OMSI-Dev/Helmet_Drop/Documentation/Helmet - Block Diagram.jpg

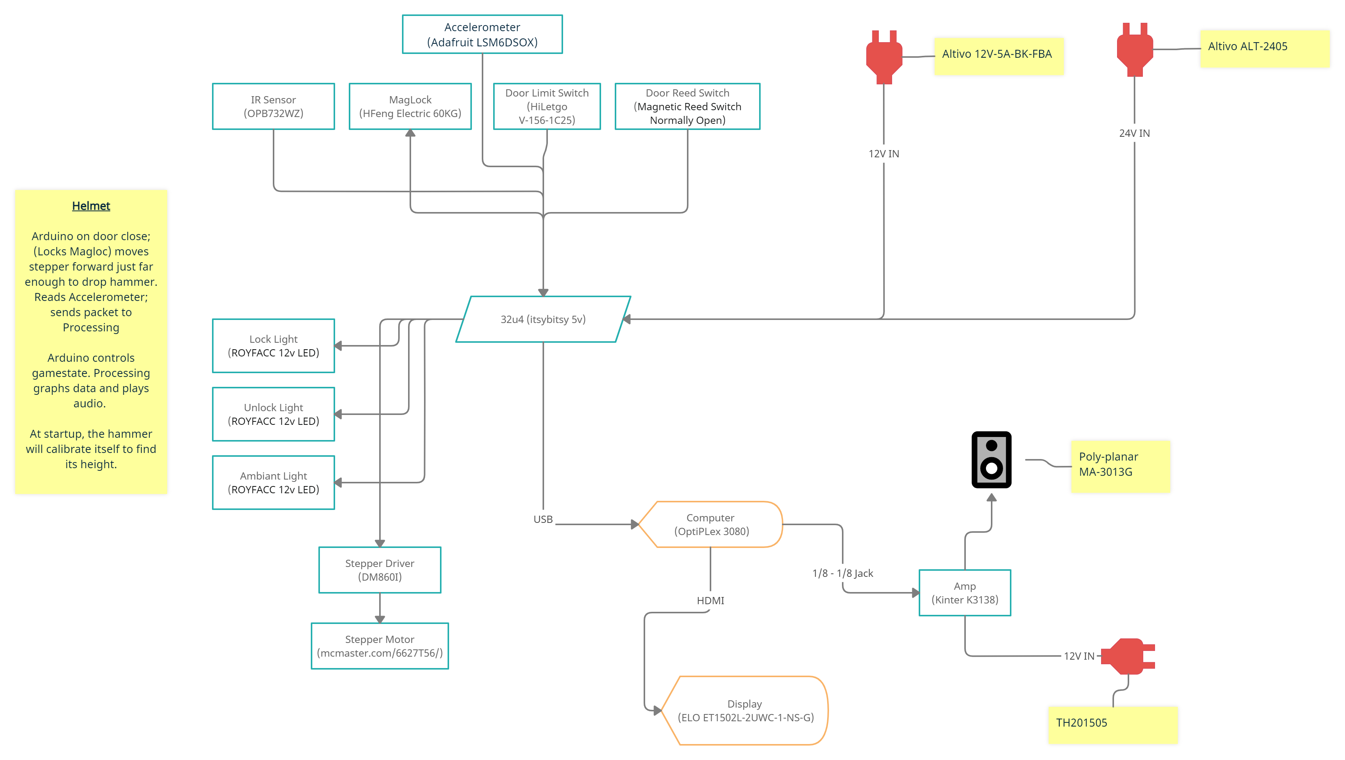
Documentation/Helmet - Block Diagram.jpg
