OMSI-Dev/Helmet_Drop/Helmet_Processing/Helmet_drop/data/images/1_en.png

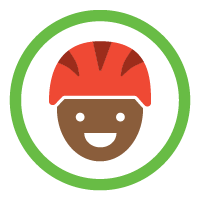
Helmet_Processing/Helmet_drop/data/images/1_en.png
