OMSI-Dev/Helmet_Drop/Helmet_Processing/Helmet_drop/data/images/2_en.png

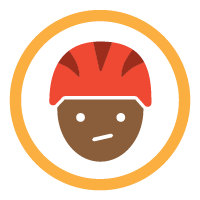
Helmet_Processing/Helmet_drop/data/images/2_en.png
