OMSI-Dev/Helmet_Drop/Documentation/Helmet - BOM.pdf

Item | QTY | Cost per Unit | Link
ItsyBitsy 5V (32u4) | 1 | $9.95 https://www.adafruit.com/product/3677
Power Strip (Relay) | 1 | $34.95 https://www.adafruit.com/product/2935
ALITOVE DC 12V 5A | 1 | $12.99 https://a.co/d/gC0HhTv
ALITOVE DC 24V 5A | 1 | $20.99 | https://a.co/d/0N48LrR
Kinter K3138 (include PSU) | 1 | $29.99 | https://a.co/d/7kK4p4w
Poly-planar (MA-3013G) (2-pair) | 1 | $73.00 | https://a.co/d/jeAjoWd
1/8 to 1/8 stereo cable | 1 | $9.83 | https://a.co/d/8GvUhxT
IR Sensor OPB732WZ | 1 | $5.57 | https://www.digikey.com/short/3n2pftft
Accelerometer LSM6DSOX | 1 | $11.95 | https://www.adafruit.com/product/4438
MagLock HFeng Electric 60KG | 1 | $16.99 | https://a.co/d/hN2lu2c
USB A-Male to Micro B | 1 | $7.45 | https://a.co/d/1P6mdxp
Limit Switch HiLetgo V-156-1C25 | 1 | $7.79 | https://a.co/d/arL1Zya
Magnetic Reed Switch Normally Open | 1 | $9.99 | https://a.co/d/4pM38kd
ROYFACC LED (3 Modules) | 3 | $11.99 | https://a.co/d/9AUnh9M
Stepper Driver DM860I | 1 | $53.73 | https://www.omc-stepperonline.com/digital-stepper-driver-2-4-7-2a-20-80vdc-for-nema-34-stepper-motor-cnc-drive-dm860i
Stepper NEMA 34 | 1 | $180.50 | mcmaster.com/6627T56/

Circuit
Mosfet SI7460DP-T1-GE3 | | $3.20 | https://mou.sr/3GcY9ni
10K SMD Resistors | | $0.10 | https://www.digikey.com/short/b225jcwt
Phoenix connectors (2-pin) Male | 4 | $0.86 | https://www.digikey.com/short/v2rp7dfq
Phoenix connectors (2-pin) Female | 4 | $0.56 | https://www.digikey.com/short/2jq08mjc
Phoenix connectors (3-pin) Male | 3 | $0.99 https://www.digikey.com/short/0bnhntht
Phoenix connectors (3-pin) Female | 3 | $0.61 https://www.digikey.com/short/tmn3hnwd
Phoenix connectors (4-pin) Male | 2 | $1.31 https://www.digikey.com/short/q49w7p2v
Phoenix connectors (4-pin) Female | 2 | $0.80 https://www.digikey.com/short/z0fpdm75
Phoenix connectors (5-pin) Male | - | $1.64 https://www.digikey.com/short/pq89nvjq
Phoenix connectors (5-pin) Female | - | $0.79 https://www.digikey.com/short/rcw1rhhv
Phoenix connectors (6-pin) Male | 1 | $1.75 https://www.digikey.com/short/v2b0mqv0
Phoenix connectors (6-pin) Female | 1 | $0.94 https://www.digikey.com/short/rm748vpc
