OMSI-Dev/Helmet_Drop/Eagle/Phoenix Connector_3_Pin v2.step

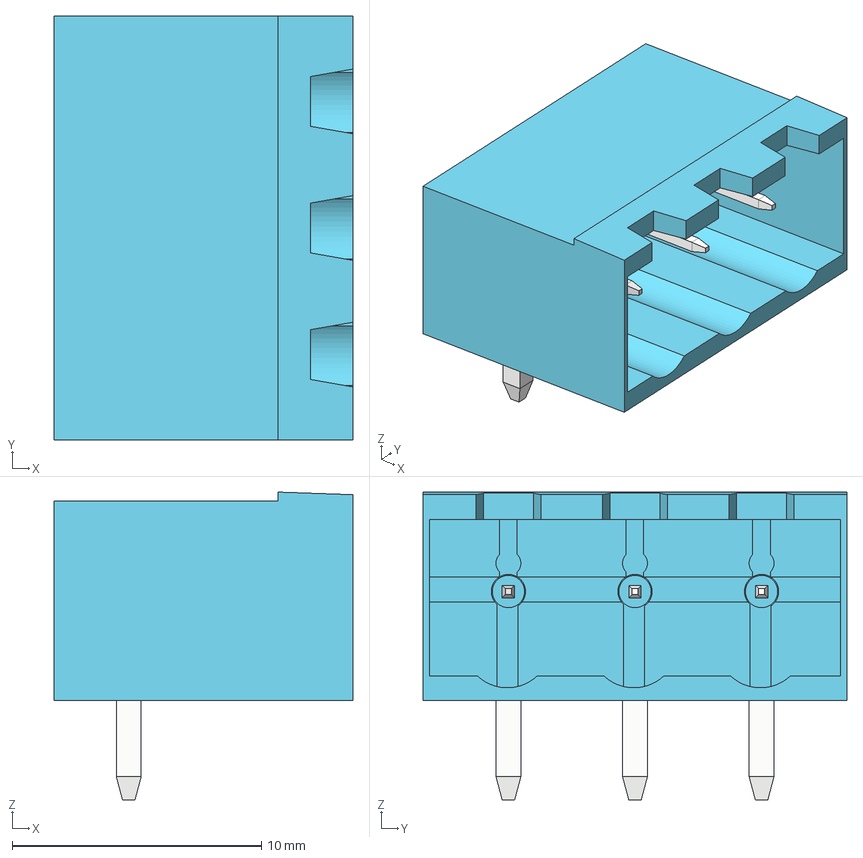
[picture p4: CAD file, 2022-09-12]
Eagle/Phoenix Connector_3_Pin v2.step
12.0 x 17.0 x 12.4 mm
