OMSI-Dev/Helmet_Drop/Eagle/Helmet_Drop_V2.1.brd

## EAGLE design Eagle/Helmet_Drop_V2.1.brd (2023-10-09)

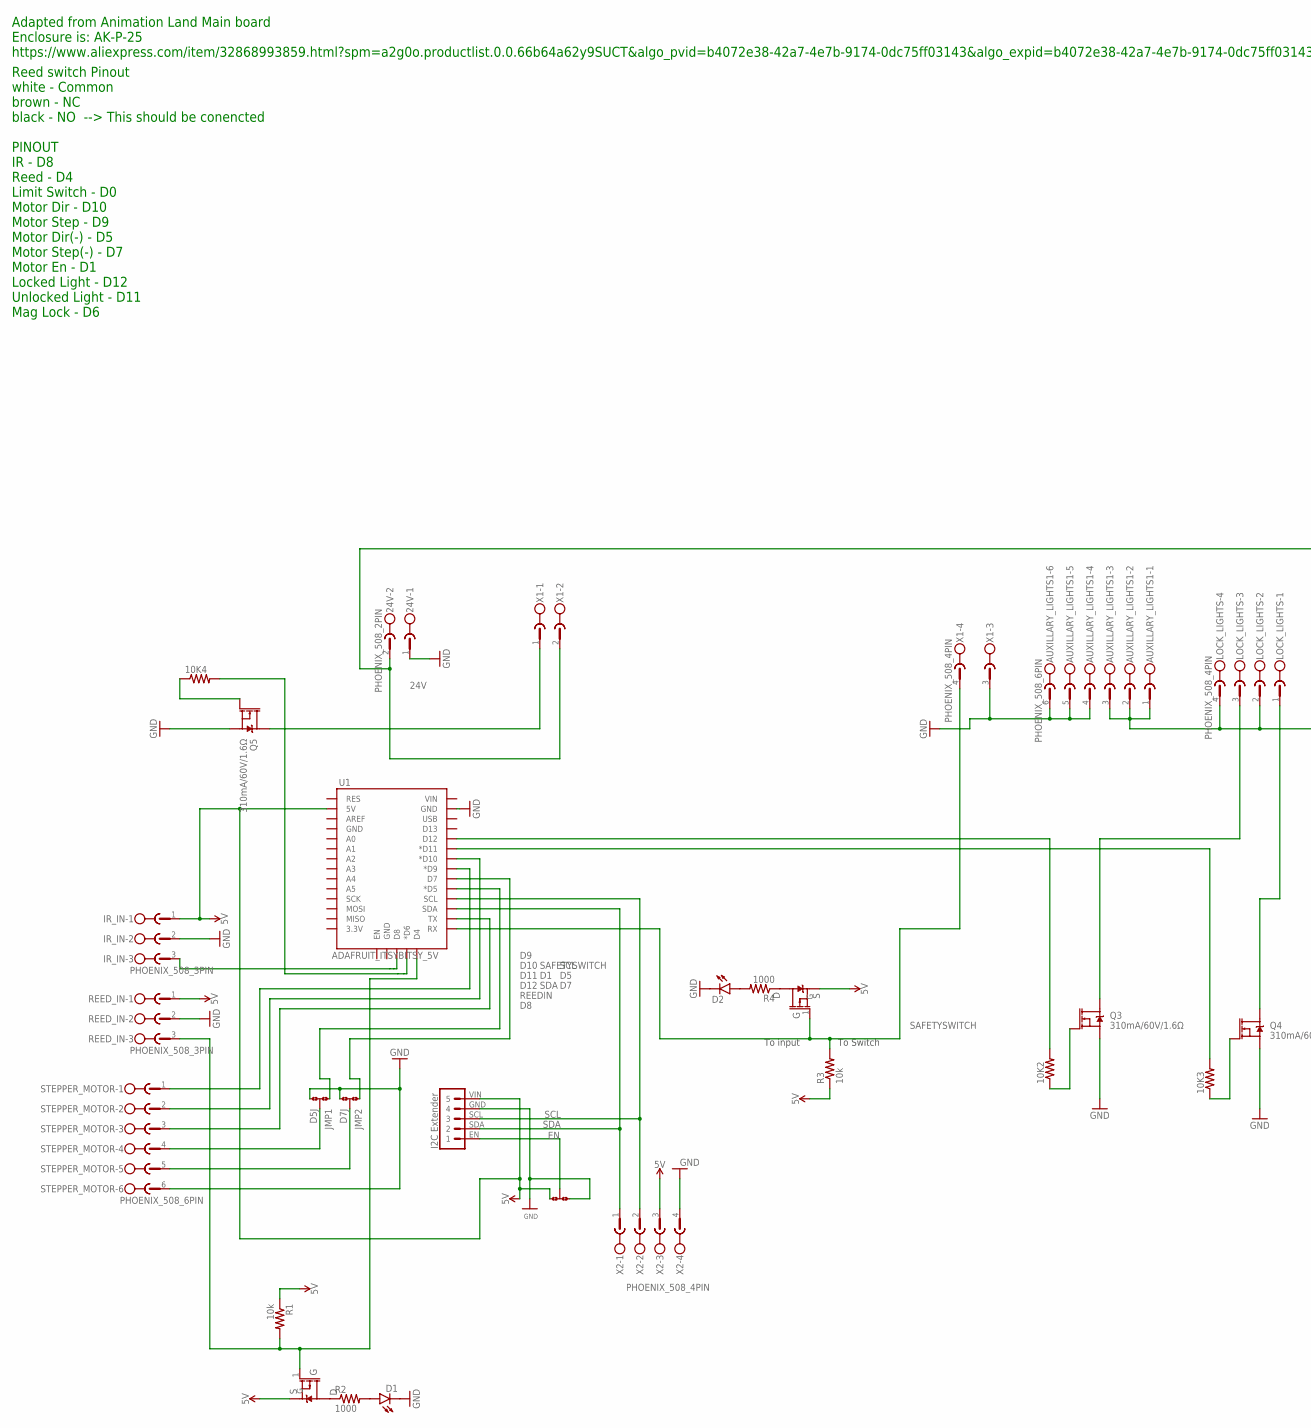
[picture p5: schematic Helmet_Drop_V2.1.sch, part in row 1, column 1]

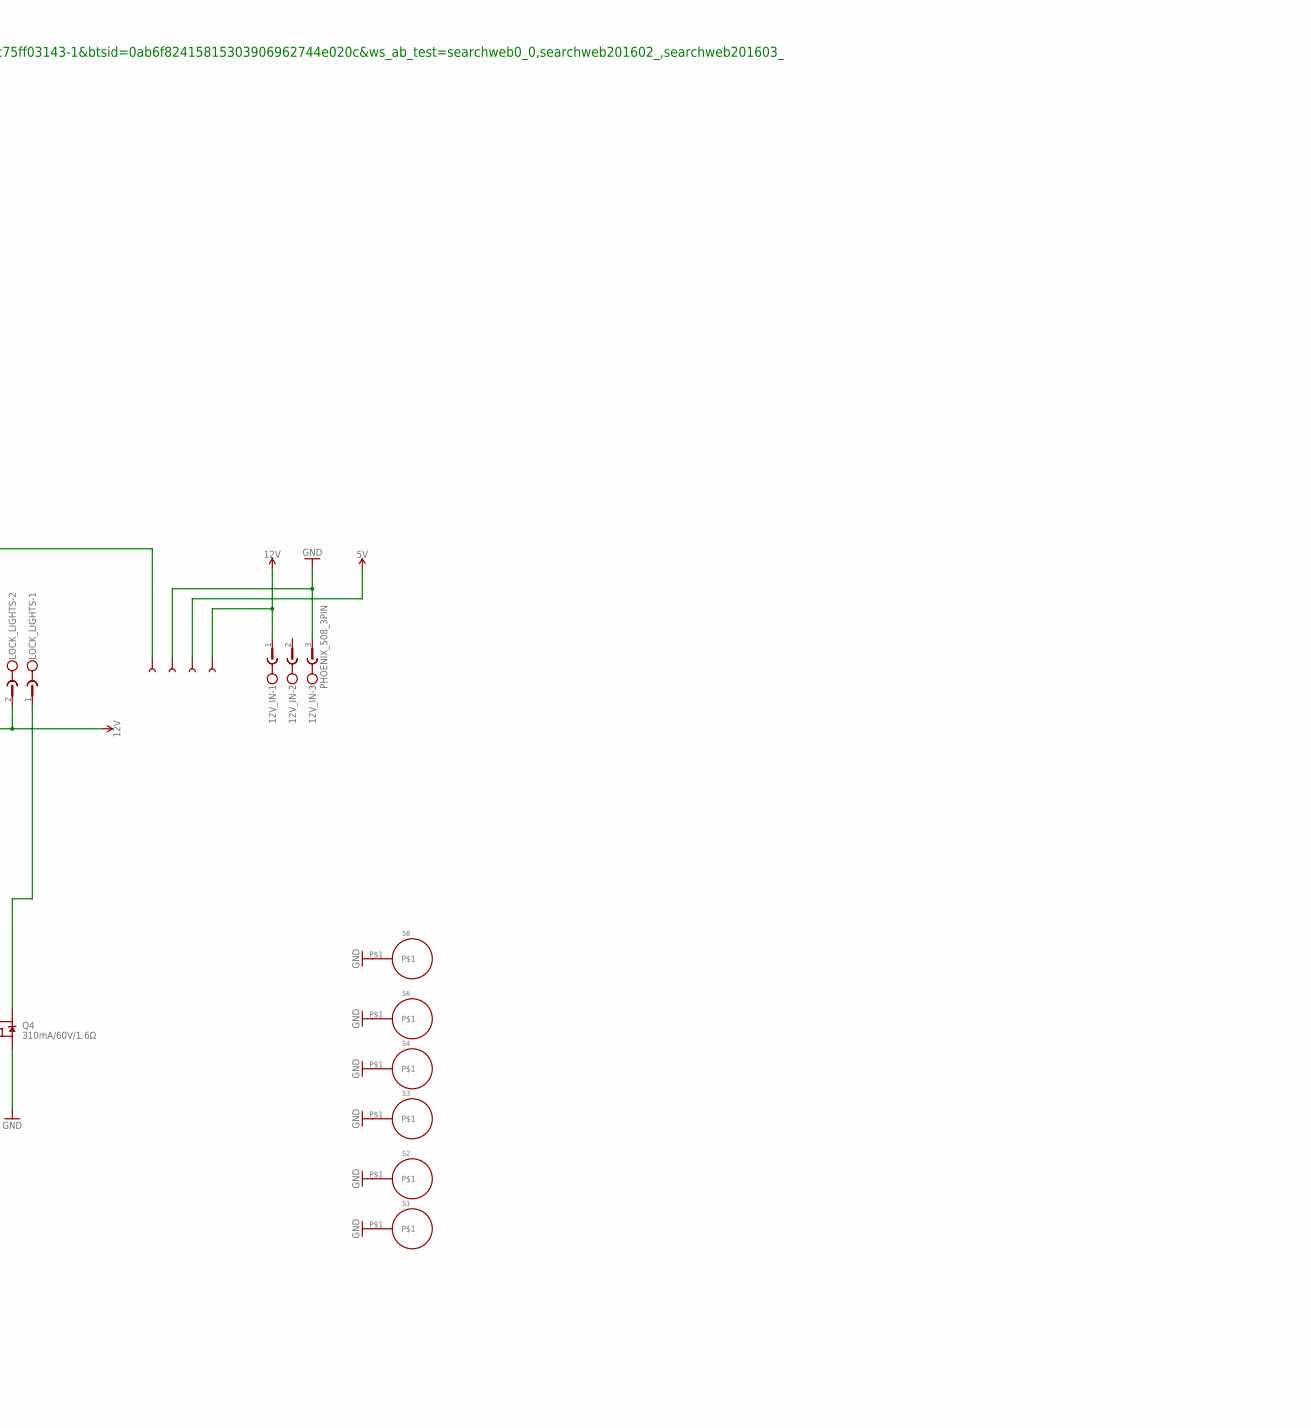
[picture p6: schematic Helmet_Drop_V2.1.sch, part in row 1, column 2]

Parts:
10K2, 10K3, 10K4: RESISTORS0805-RES; SMD_RESISTOR_0805
12V_IN: PHOENIX_508_3PIN
24V: PHOENIX_508_2PIN
AUXILLARY_LIGHTS1: PHOENIX_508_6PIN
D1, D2: GENERIC_LED1206; SMD_LED-1206
IR_IN: PHOENIX_508_3PIN
JMP1, JMP2, JMP3: SMD_JUMPERA; JUMPER_A-OR
LOCK_LIGHTS: PHOENIX_508_4PIN
Q1, Q2: MOSFET-PCHIRLML9301TRPBF; SOT23-3
Q3, Q4, Q5: 310mA/60V/1.6Ω; SO-8_POWER_PAK
R1, R3: 10k; SMD_RESISTOR_0805
R2, R4: 1000; SMD_RESISTOR_0805
REED_IN: PHOENIX_508_3PIN
S1, S2, S3, S4, S6, S8: GND_HOLE
STEPPER_MOTOR: PHOENIX_508_6PIN
TP1, TP2, TP3, TP4: TEST_POINTTP_15TH_THRU; TESTPOINT_HEADER_1X01
U1: ADAFRUIT_ITSYBITSY_5V; ADAFRUIT_ITSYBITSY
U$1: I2C_EXTENDER
X1, X2: PHOENIX_508_4PIN

Connections:
5V: IR_IN.1, JMP3.1, Q1.2 (S), Q2.2 (S), R1.1, R3.1, REED_IN.1, TP3.P$1, U1.5V, U$1.VIN (5), X2.3
12V: 12V_IN.1, AUXILLARY_LIGHTS1.1, AUXILLARY_LIGHTS1.2, AUXILLARY_LIGHTS1.3, LOCK_LIGHTS.2, LOCK_LIGHTS.4, TP4.P$1
24V: 24V.2, TP1.P$1, X1.2
D1: STEPPER_MOTOR.3, U1.TX
D5: JMP1.1, U1.D5 (*D5)
D5J: JMP1.2, STEPPER_MOTOR.4
D7: JMP2.1, U1.D7
D7J: JMP2.2, STEPPER_MOTOR.5
D8: IR_IN.3, U1.D8
D9: STEPPER_MOTOR.1, U1.D9 (*D9)
D10: STEPPER_MOTOR.2, U1.D10 (*D10)
D11: 10K3.2, U1.D11 (*D11)
D12: 10K2.2, U1.D12
EN: JMP3.2, U$1.EN (1)
GND: 12V_IN.3, 24V.1, AUXILLARY_LIGHTS1.4, AUXILLARY_LIGHTS1.5, AUXILLARY_LIGHTS1.6, D1.C, D2.C, IR_IN.2, JMP1.3, JMP2.3, JMP3.3, Q3.S, Q4.S, Q5.S, REED_IN.2, S1.P$1, S2.P$1, S3.P$1, S4.P$1, S6.P$1, S8.P$1, STEPPER_MOTOR.6, TP2.P$1, U1.GND@2 (GND), U$1.GND (4), X1.3, X2.4
unnamed: 10K4.2, U1.D6 (*D6)
unnamed: Q1.3 (D), R4.1
unnamed: D2.A, R4.2
unnamed: Q2.3 (D), R2.1
unnamed: D1.A, R2.2
unnamed: LOCK_LIGHTS.3, Q3.D1 (D)
unnamed: LOCK_LIGHTS.1, Q4.D1 (D)
unnamed: 10K2.1, Q3.G
unnamed: Q5.D1 (D), X1.1
unnamed: 10K3.1, Q4.G
unnamed: 10K4.1, Q5.G
REEDIN: Q2.1 (G), R1.2, REED_IN.3, U1.D4
SAFETYSWITCH: Q1.1 (G), R3.2, U1.RX, X1.4
SCL: U1.SCL, U$1.SCL (3), X2.2
SDA: U1.SDA, U$1.SDA (2), X2.1

Notes on the sheet:
Adapted from Animation Land Main board Enclosure is: AK-P-25 https://www.aliexpress.com/item/32868993859.html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…
Reed switch Pinout white - Common brown - NC black - NO --> This should be conencted PINOUT IR - D8 Reed - D4 Limit Switch - D0 Motor Dir - D10 Motor Step - D9 Motor Dir(-) - D5 Motor Step(-) - D7 Motor En - D1 Locked Light - D12 Unlocked Light - D11 Mag Lock - D6
To Switch
To input

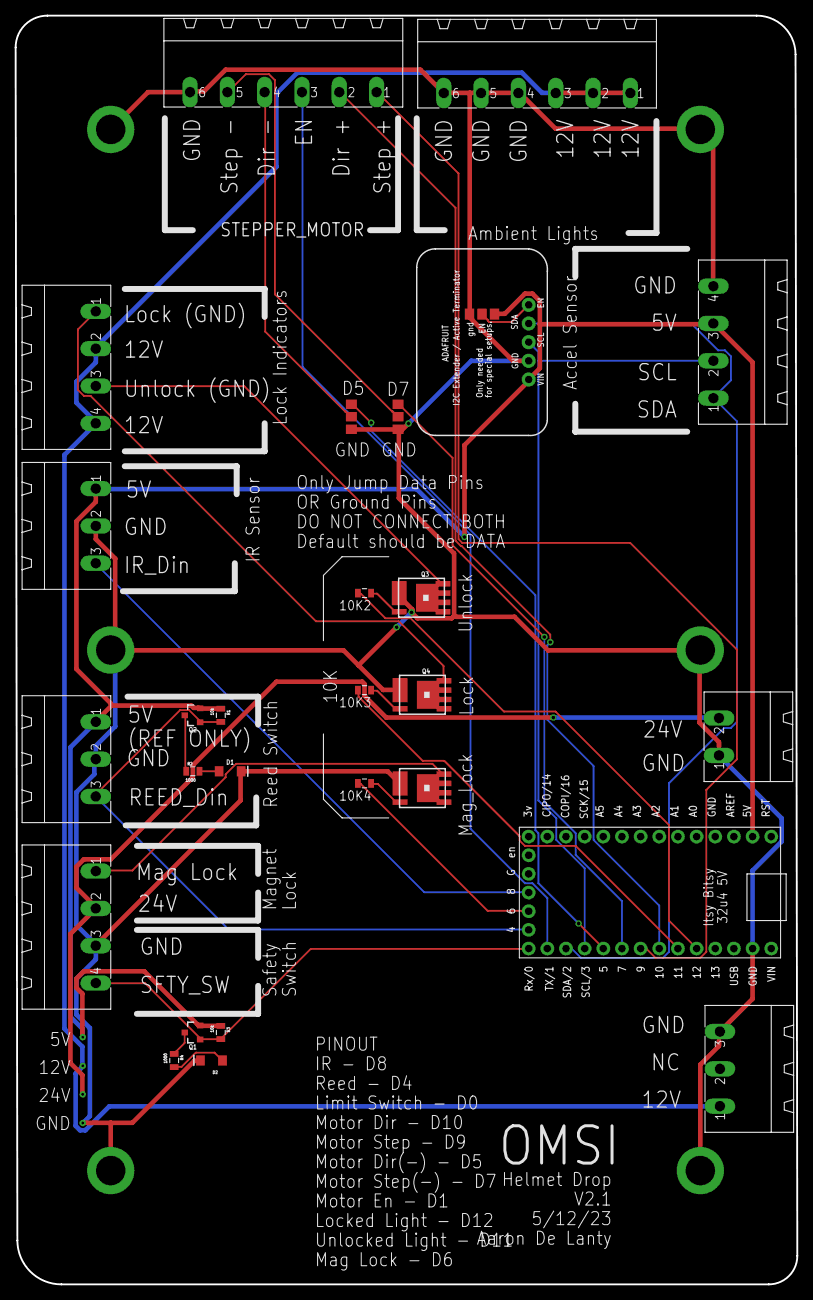
[picture p7: board Helmet_Drop_V2.1.brd from above]

Board: 2 copper layers, 106.4 x 172.7 mm, 38 parts (0 on the bottom side), 30 nets.
