OMSI-Dev/Helmet_Drop/Eagle/Extra Boards/IR_Interruptor board.brd

## EAGLE design Eagle/Extra Boards/IR_Interruptor board.brd (2023-10-06)

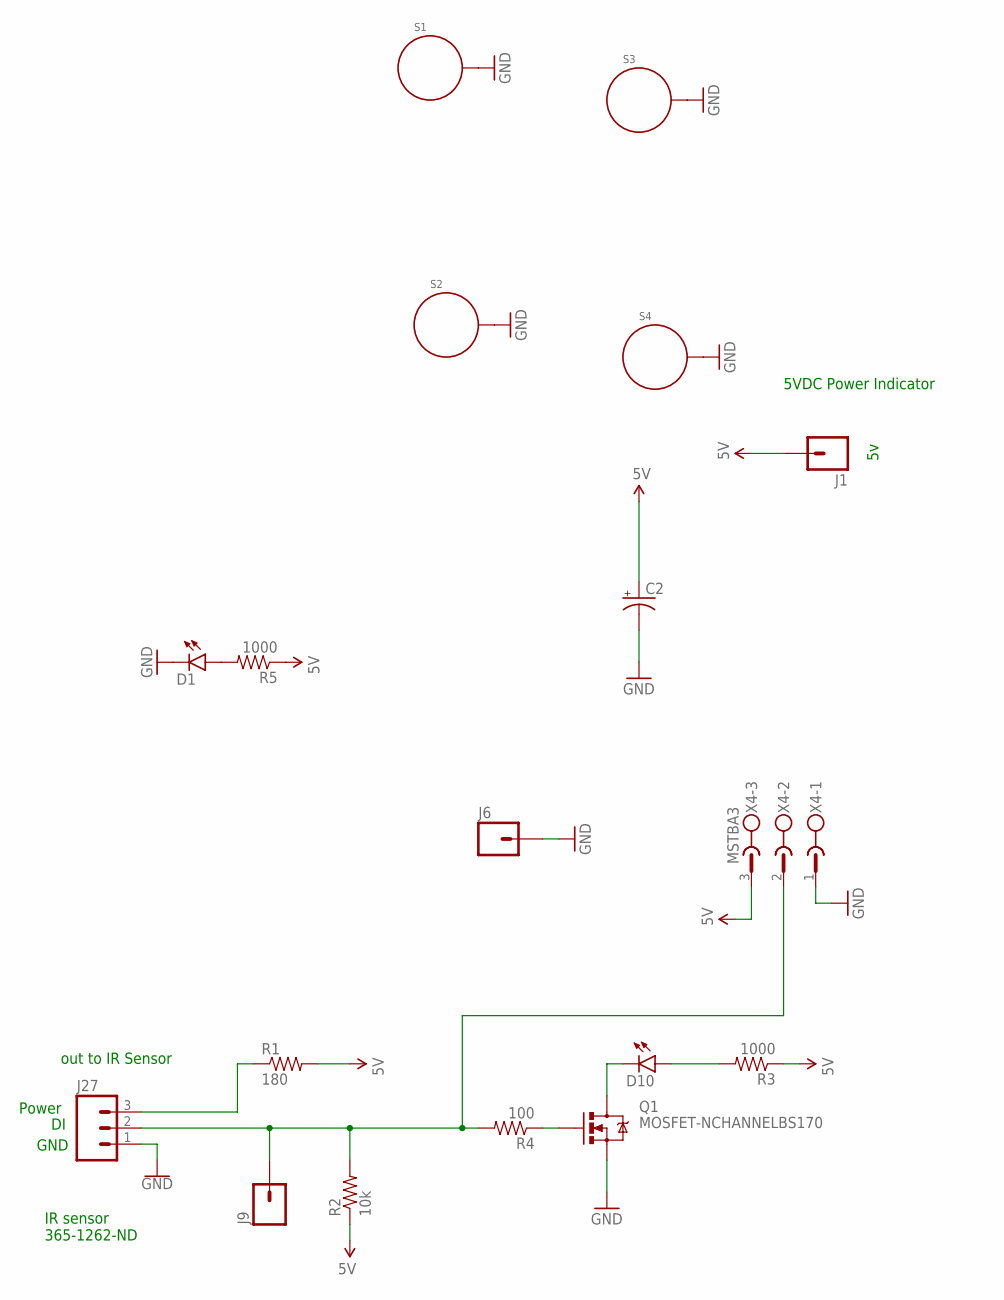
[picture p8: schematic IR_Interruptor board.sch]

Parts:
C2: CAP_POLPTH2; CPOL-RADIAL-10UF-25V
D1, D10: LED1206; LED-1206
J1, J6, J9: M01PTH; 1X01
J27: M03SCREW; SCREWTERMINAL-3.5MM-3
Q1: MOSFET-NCHANNELBS170; TO-92
R1: 180; 0805
R2: 10k; 0805
R3, R5: 1000; 0805
R4: 100; 0805
S1, S2, S3, S4: STANDOFF_ELECTRICAL; STANDOFF-ELECTRICAL
X4: MSTBA3

Connections:
5V: C2.1 (+), J1.1, R1.2, R2.1, R3.1, R5.1, X4.3
DO: J9.1, J27.2, R2.2, R4.2, X4.2
GND: C2.2 (-), D1.C, J6.1, J27.1, Q1.3 (S), S1.P1, S2.P1, S3.P1, S4.P1, X4.1
unnamed: Q1.2 (G), R4.1
unnamed: D10.C, Q1.1 (D)
unnamed: D1.A, R5.2
unnamed: D10.A, R3.2
POWER: J27.3, R1.1

Notes on the sheet:
5VDC Power Indicator
IR sensor 365-1262-ND
out to IR Sensor
GND
Power

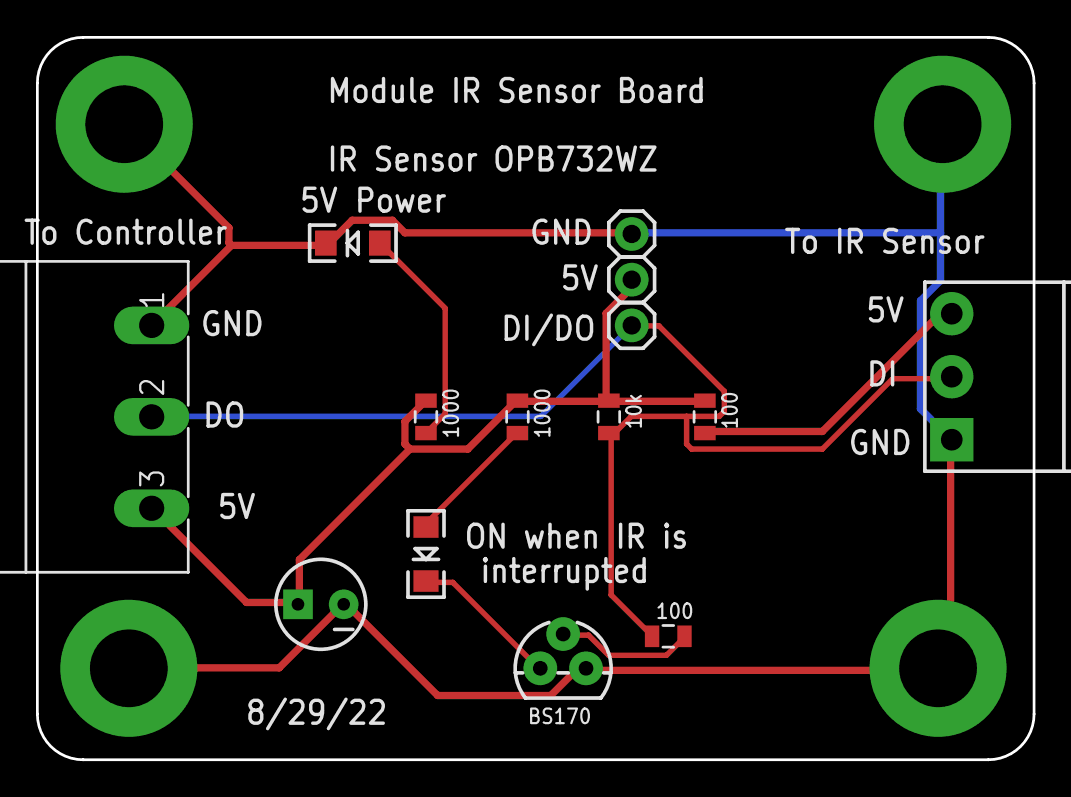
[picture p9: board IR_Interruptor board.brd from above]

Board: 2 copper layers, 55.4 x 40.1 mm, 18 parts (0 on the bottom side), 8 nets.
