OMSI-Dev/Helmet_Drop/Eagle/Extra Boards/Acel_Jumper/accel_jumper.brd

## EAGLE design Eagle/Extra Boards/Acel_Jumper/accel_jumper.brd (2022-12-22)

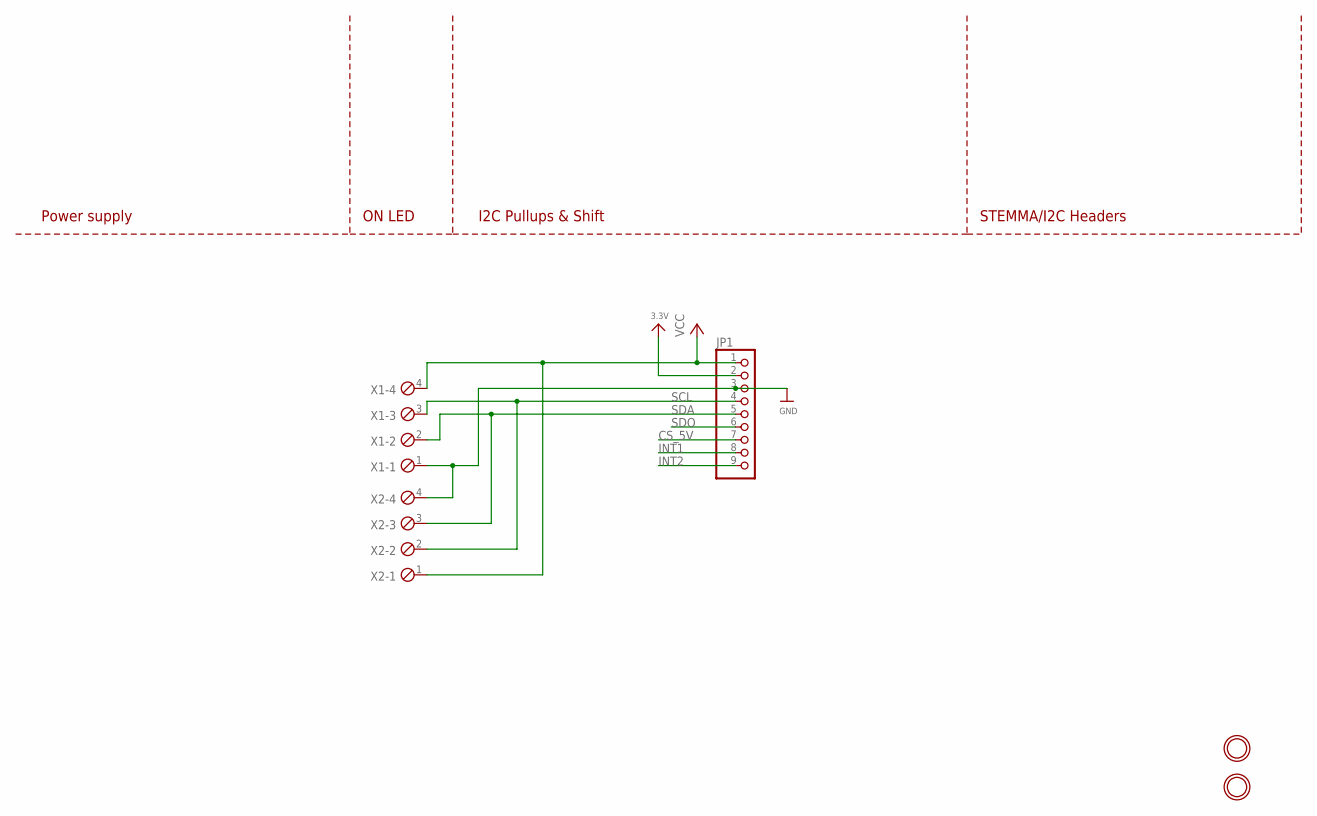
[picture p10: schematic accel_jumper.sch, sheet 2]

Parts:
JP1: HEADER-1X970MIL; 1X09_ROUND_70
U$1, U$17: MOUNTINGHOLE2.5; MOUNTINGHOLE_2.5_PLATED
X1, X2: MPT4; 4POL254

Connections:
3.3V: JP1.2
CS_5V: JP1.7
GND: JP1.3, X1.1, X2.4
INT1: JP1.8
INT2: JP1.9
SCL: JP1.4, X1.3, X2.2
SDA: JP1.5, X1.2, X2.3
SDO: JP1.6
VCC: JP1.1, X1.4, X2.1

Notes on the sheet:
I2C Pullups & Shift
STEMMA/I2C Headers
ON LED
Power supply

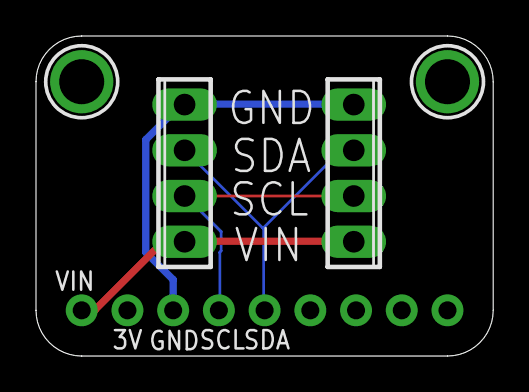
[picture p11: board accel_jumper.brd from above]

Board: 2 copper layers, 25.4 x 17.8 mm, 5 parts (0 on the bottom side), 4 nets.
