OMSI-Dev/Helmet_Drop/Eagle/Extra Boards/Extender Jumper/Extender_Jumper.brd

## EAGLE design Eagle/Extra Boards/Extender Jumper/Extender_Jumper.brd (2022-12-22)

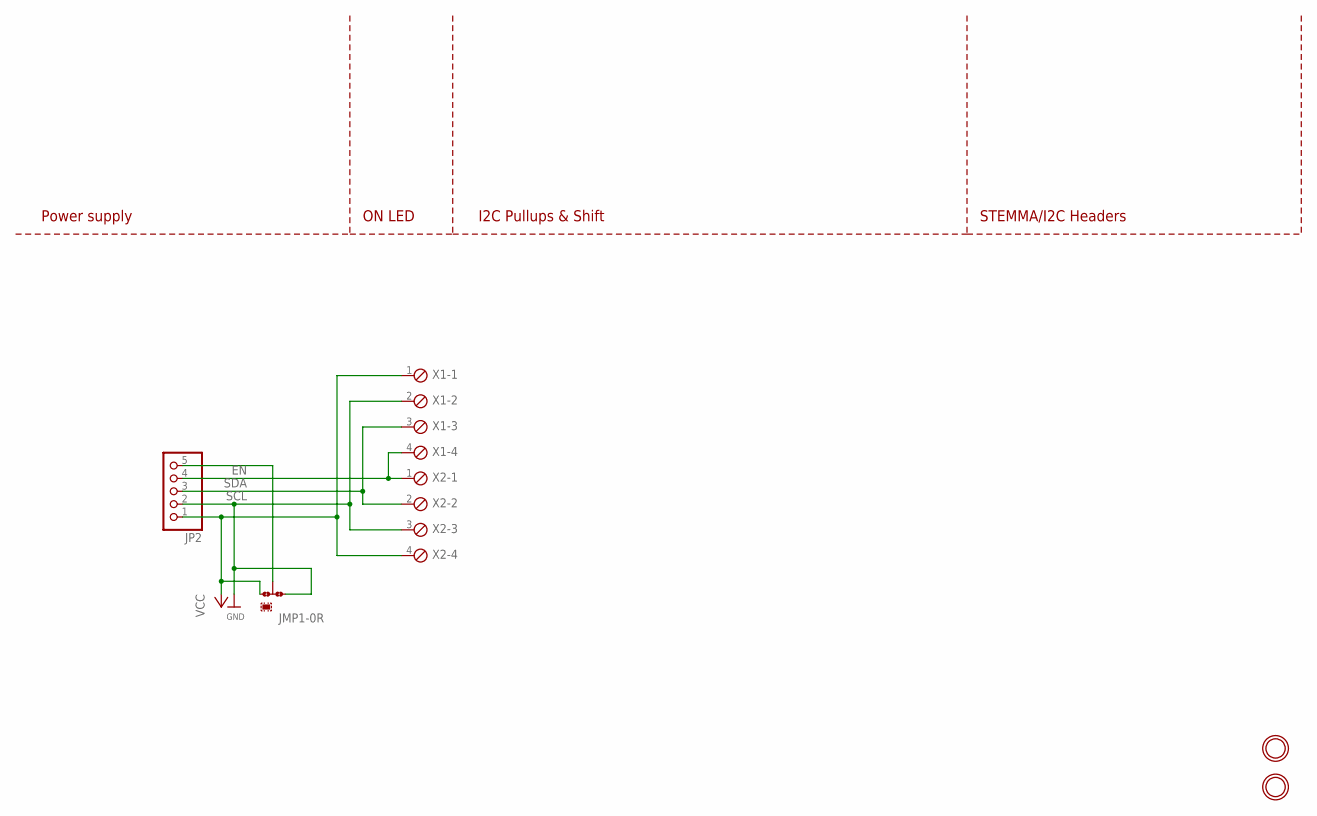
[picture p12: schematic Extender_Jumper.sch]

Parts:
JMP1: 0R-JUMPA; A0R-JMP
JP2: HEADER-1X570MIL; 1X05_ROUND_70
U$19, U$21: MOUNTINGHOLE2.5; MOUNTINGHOLE_2.5_PLATED
X1, X2: MPT4; 4POL254

Connections:
EN: JMP1.2, JP2.5
GND: JMP1.3, JP2.2, X1.2, X2.3
SCL: JP2.3, X1.3, X2.2
SDA: JP2.4, X1.4, X2.1
VCC: JMP1.1, JP2.1, X1.1, X2.4

Notes on the sheet:
I2C Pullups & Shift
STEMMA/I2C Headers
ON LED
Power supply

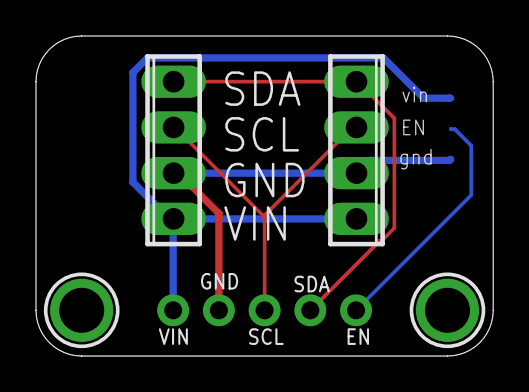
[picture p13: board Extender_Jumper.brd from above]

Board: 2 copper layers, 25.4 x 17.8 mm, 6 parts (1 on the bottom side), 5 nets.
