OMSI-Dev/Helmet_Drop/Eagle/Helmet_Drop_V1.brd

## EAGLE design Eagle/Helmet_Drop_V1.brd (2022-11-16, an earlier design)

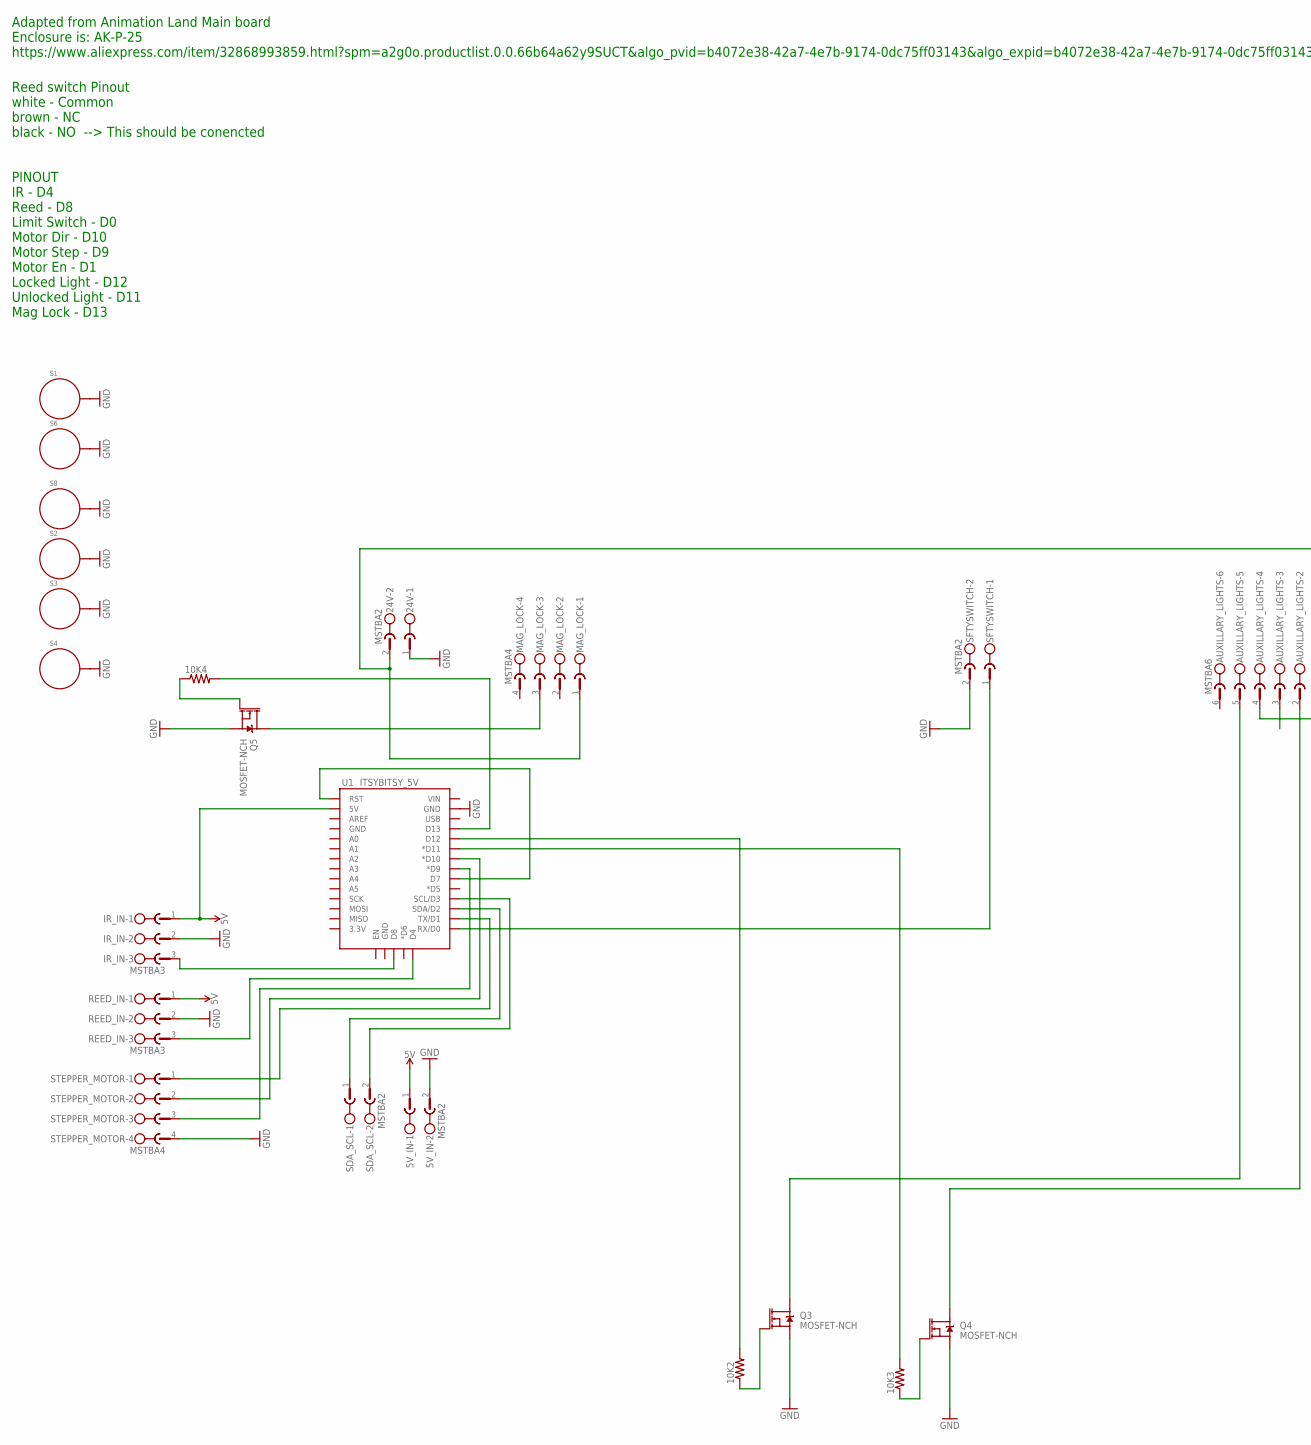
[picture p14: schematic Helmet_Drop_V1.sch, part in row 1, column 1]

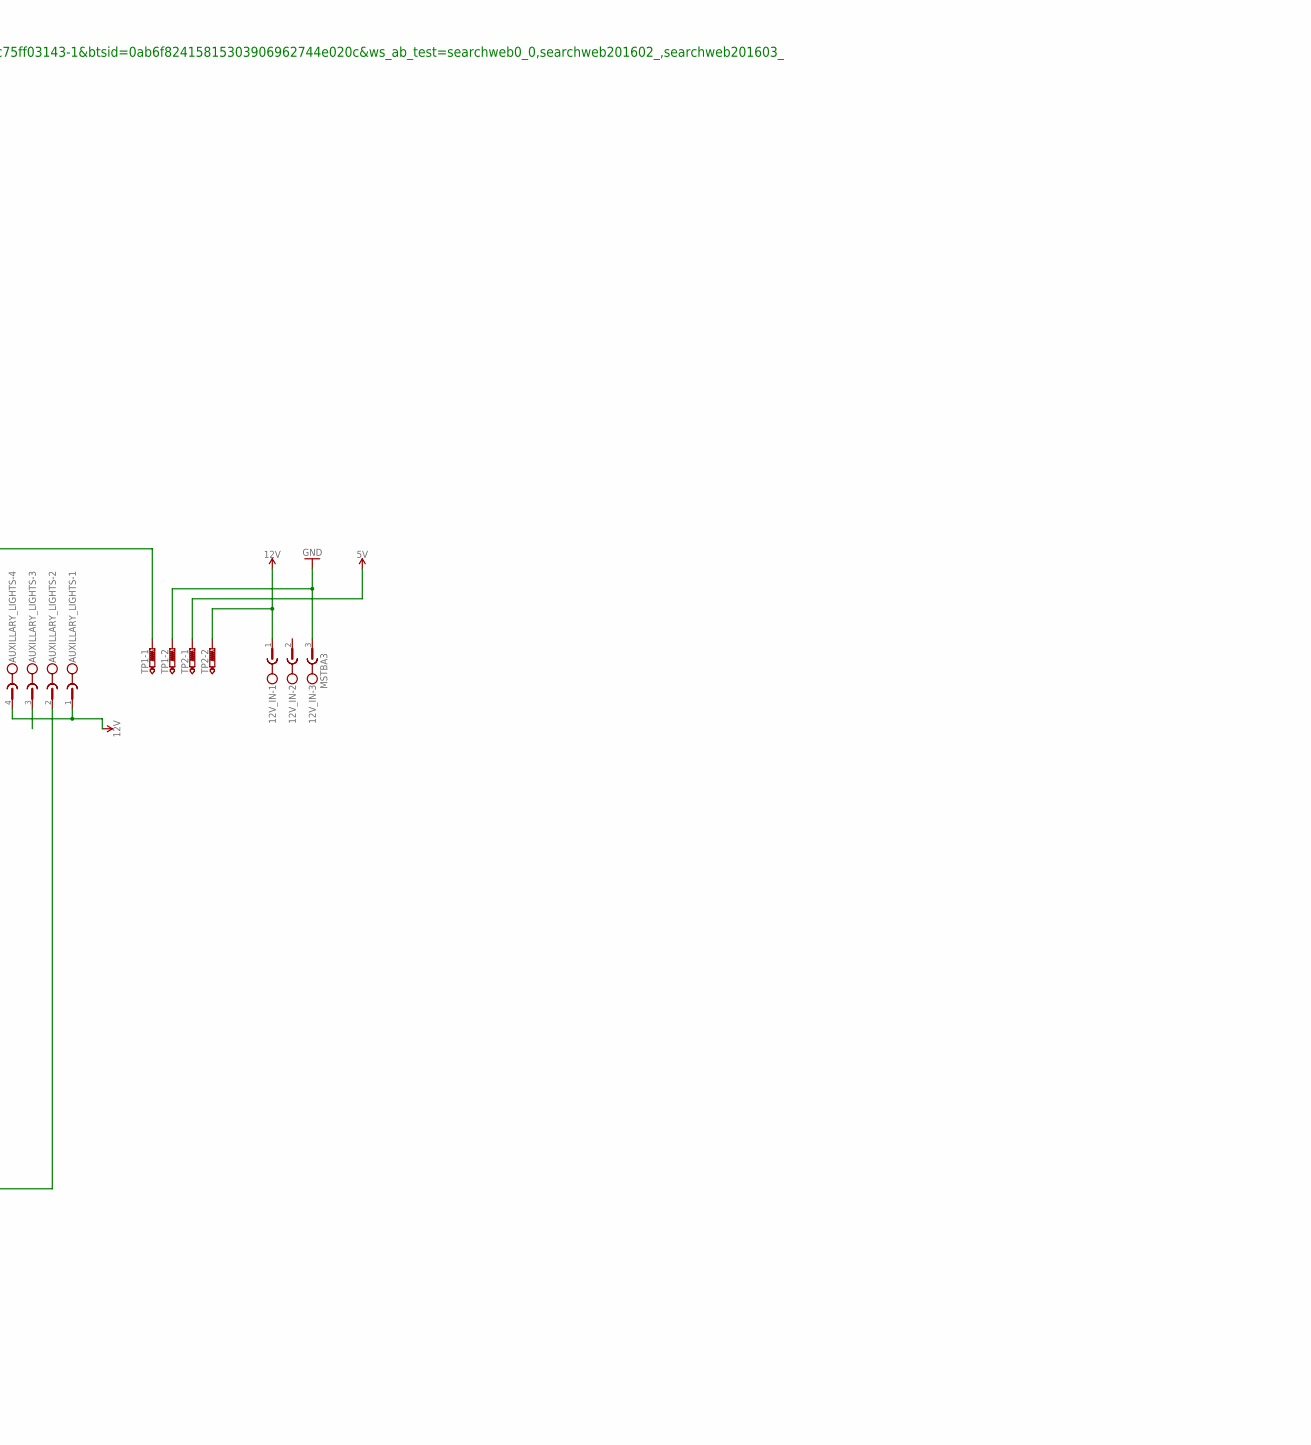
[picture p15: schematic Helmet_Drop_V1.sch, part in row 1, column 2]

Parts:
5V_IN, 24V: MSTBA2
10K2, 10K3, 10K4: R-US_M0805; M0805
12V_IN: MSTBA3
AUXILLARY_LIGHTS: MSTBA6
IR_IN: MSTBA3
MAG_LOCK: MSTBA4
Q3, Q4, Q5: MOSFET-NCH; SO-8_POWER_PAK
REED_IN: MSTBA3
S1, S2, S3, S4, S6, S8: STANDOFF_ELECTRICAL5-32; STANDOFF_ELECTRICAL_5_32
SDA_SCL: MSTBA2
SFTYSWITCH: MSTBA2
STEPPER_MOTOR: MSTBA4
TP1, TP2: PTR2; P2-38-17
U1: ITSYBITSY_5V; ADAFRUIT_LENOARDO

Connections:
5V: 5V_IN.1, IR_IN.1, REED_IN.1, TP2.TP-1, U1.5V
12V: 12V_IN.1, AUXILLARY_LIGHTS.1, AUXILLARY_LIGHTS.4, TP2.TP-2
GND: 5V_IN.2, 12V_IN.3, 24V.1, IR_IN.2, Q3.S, Q4.S, Q5.S, REED_IN.2, S1.P1, S2.P1, S3.P1, S4.P1, S6.P1, S8.P1, SFTYSWITCH.2, STEPPER_MOTOR.4, TP1.TP-2, U1.GND@2 (GND)
unnamed: 10K4.2, U1.D13
unnamed: SFTYSWITCH.1, U1.RX (RX/D0)
unnamed: STEPPER_MOTOR.3, U1.D9 (*D9)
unnamed: U1.D7, U1.RES (RST)
unnamed: STEPPER_MOTOR.2, U1.D10 (*D10)
unnamed: AUXILLARY_LIGHTS.5, Q3.D1 (D)
unnamed: STEPPER_MOTOR.1, U1.TX (TX/D1)
unnamed: 10K2.1, Q3.G
unnamed: REED_IN.3, U1.D4
unnamed: IR_IN.3, U1.D8
unnamed: SDA_SCL.1, U1.SDA (SDA/D2)
unnamed: SDA_SCL.2, U1.SCL (SCL/D3)
unnamed: 10K2.2, U1.D12
unnamed: MAG_LOCK.3, Q5.D1 (D)
unnamed: 24V.2, MAG_LOCK.1, TP1.TP-1
unnamed: AUXILLARY_LIGHTS.2, Q4.D1 (D)
unnamed: 10K3.2, U1.D11 (*D11)
unnamed: 10K3.1, Q4.G
unnamed: 10K4.1, Q5.G

Notes on the sheet:
Adapted from Animation Land Main board Enclosure is: AK-P-25 https://www.aliexpress.com/item/32868993859.html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…
Reed switch Pinout white - Common brown - NC black - NO --> This should be conencted PINOUT IR - D4 Reed - D8 Limit Switch - D0 Motor Dir - D10 Motor Step - D9 Motor En - D1 Locked Light - D12 Unlocked Light - D11 Mag Lock - D13

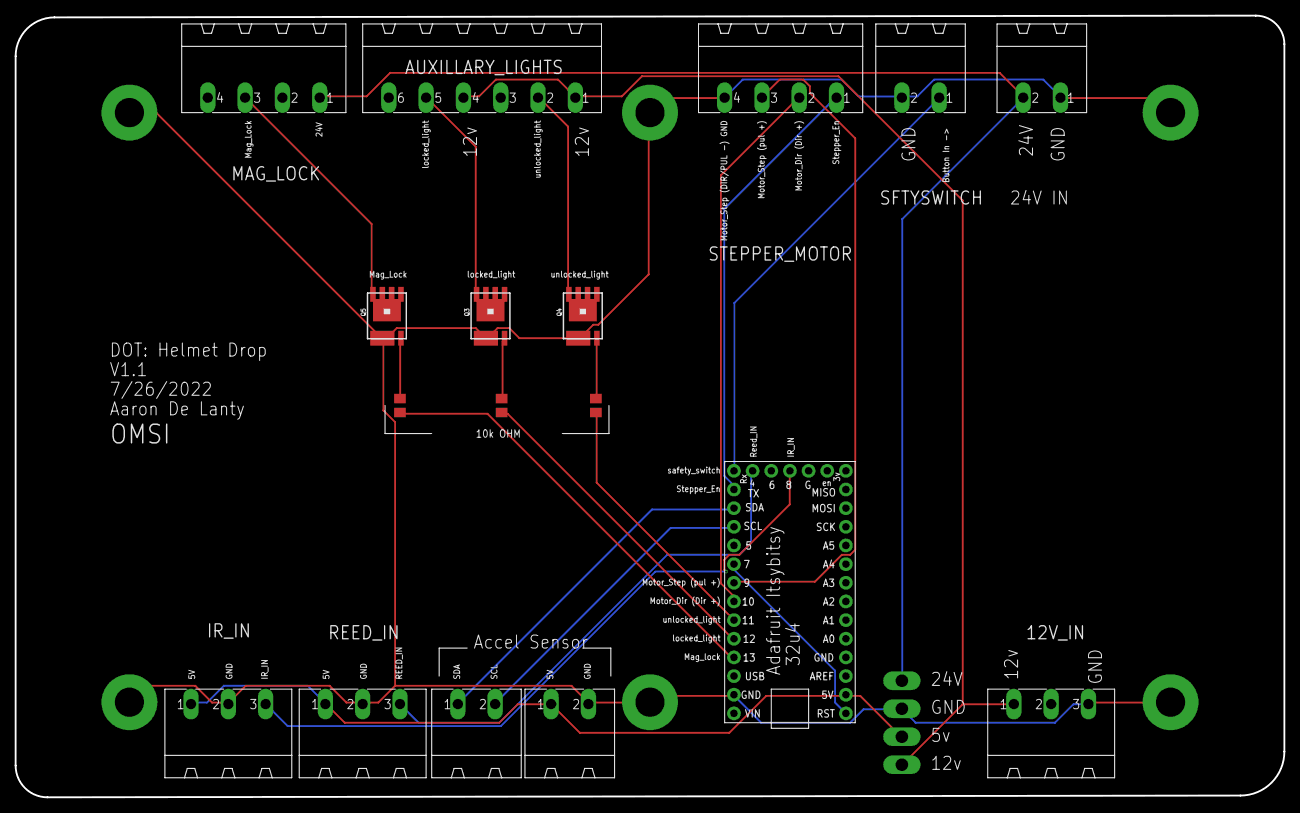
[picture p16: board Helmet_Drop_V1.brd from above]

Board: 2 copper layers, 172.7 x 106.4 mm, 25 parts (0 on the bottom side), 22 nets.
