OMSI-Dev/Helmet_Drop/(commit log)

2022-09-19 Updated CAM for circuit manufacturing
    [IR_Interruptor board.brd]
2022-11-16 Updated to make newest repository location
    [Helmet - BOM.ods, Helmet - BOM.xlsx, Helmet_Drop_V1.brd, Helmet_Drop_V1.sch]
2023-01-07 updated homing and pins
2023-02-16 added drift correction & door catch
    [Helmet_drop.pde, hammer_functions.h, main.cpp, pin_define.h, safety_functions.h]
2023-02-16 fixed bool & added double check for safety
    [hammer_functions.h, safety_functions.h]
2023-04-03 Update Helmet_drop.pde
    This should correct errors when applying to the graph. Generates a logFile. If fails 2nd attempt to update it will close the program and update the log.
    [Helmet_drop.pde]
2023-05-16 Moved connectors for ease of access
    [Helmet_Drop_V2.0.brd, Helmet_Drop_V2.0.sch]
2023-06-22 board fix
    [Helmet_Drop_V2.0.brd, Helmet_Drop_V2.1.brd, Helmet_Drop_V2.1.sch]
2023-07-20 e-homing switch added
2023-09-18 update 5V lead and comments
2023-10-06 updated indicator lights
    [Extender_Jumper.brd, Extender_Jumper.sch, Helmet_Drop_V2.0.brd, Helmet_Drop_V2.0.sch, Helmet_Drop_V2.1.brd, Helmet_Drop_V2.1.sch, IR_Interruptor board.brd, IR_Interruptor board.sch]
